SystemIntelligent/porteroInteligente/README.md

# Portero Inteligente
## Descripción
La idea de los creadores es tener un equipo encargado de comunicación con el celular para poder responder el llamado de la puerta y poder abrirla a distancia.

## Integrantes
* Leonardo Pastor
* Julian Morganella
* Ezequiel Valdez
* Ezequiel Silvero
