SystemIntelligent/porteroInteligente/plano electrico.pdf

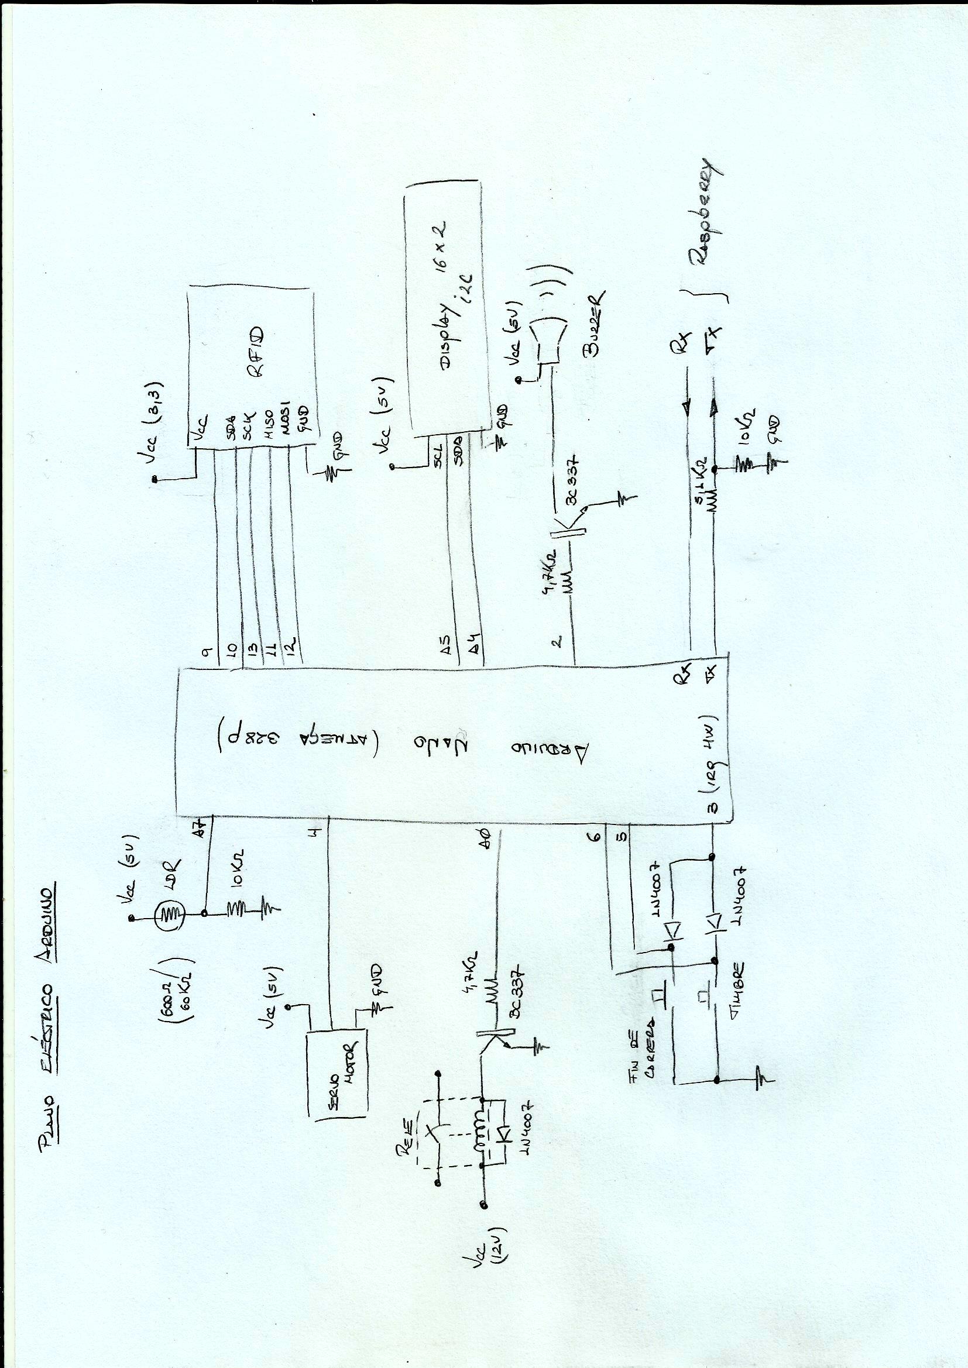
[picture p4: page 1]
