SystemIntelligent/porteroInteligente/(commit log)

2018-04-29 Create leame.txt
    Se creo la carpeta de Sistemas Embebido
2018-04-29 Create leame.txt
    Se creo el archivo leame.txt para la carpeta de Android
2018-04-29 Create leame.txt
    Se creo la carpeta Informe Final.
2018-04-29 Update README.md
    Se modificó archivo de readme
2018-05-27 * Primera versión: Prueba de Hardware involucrado en el proyecto.
    - Se probó comunicación (interfaz SPI) con módulo card reader (RFID RC522).
    - Se probó comunicación (interfaz I2C) con display de cristal Líquido 16x2.
    - Se probó buzzer.
    - Se probó biblioteca TimerOne, necesaria para utilizar el timer del ATmega328.
    - Se integraron los modulos antes descriptos, mostrando un mesaje en el display y
    emitiendo un pequeño beep cada vez que se aproxima una tarjeta al lector.
    - Actualmente no se lee ningún tipo de dato desde la tarjeta, sólo se verifica
    que la misma este en campo.
    [SmartDoorMan.ino]
2018-05-27 - Se agregó el handler que trata la interrupción de HW externa que se genera al presionar el pulsador.
2018-05-27 Se inició con la subida de archivos y ordenamiento de carpetas en eclipse.
2018-05-29 *Configuración de las propiedades del proyecto (lado raspberry, eclipse c++): - se deberá crea en el directorio raiz (ctr + t, para abrir una terminal y tipiar 'cd' luego 'cd ..' y por último una vez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
2018-05-29 - Se implemento el módulo sqlite, utilizado para interactuar con una base de datos. - Se incluyó una nueva carpeta en el proyecto 'common' donde se alojan los includes necesarios para todo el proyect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
2018-05-29 - Se configuro la estructura de carpetas, agregando las librerias faltantes.
2018-05-29 Update README.md
    Se elimina a compañera que dejó el equipo por problemas personales.
2018-05-30 * Se agregó el handler de evento serial --IMPORTANTE hay que tener encuanta que según la documentación este no es asincrónico si no que se ejecuta 1 vez por cada vuelta del loop() principal del progr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
2018-05-31 - Se le agregó a la función de evento Serial la lógica necesaria para reconocer la estructura de datos implementada en el protocolo que se va a utilizar para la comunicación entre arduino y raspberry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
2018-05-31 - Se realizaron nuevamente las configuraciones, para estandarizar con el resto de las personas del equipo
2018-05-31 - Se empezó a realizar el protocolo de armado de paquete, para la comunicación Raspberry con Arduino, del lado Raspberry.
2018-06-01 - Se agrega la funcion de checkSum para validar la veracidad de los datos enviados.
2018-06-01 - se modifico manera de armar vector de preparePack
2018-06-01 - Se corrigió problema en checkSum, y en lectura de serie.
2018-06-03 * Se agregaron todas las funciones requeridas para implementar el protocolo de comunicacón - char* calcChecksum(const char *data, int length) ---> Permite calcular el checksum de la carga útil del pa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
2018-06-03 * Se implementó la función respnsable de desarmar el paquete recibido. - char* disarmPackage(const char *package, int length);
2018-06-03 - Se definio una lista de comandos posibles (para la comunicación arduino raspberry). - Se mofidicó el tiempo de actualización del display. - Se modificó el tiempo de verificación de presencia de tar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
2018-06-03 Se corrigieron errores en el checkSum, se implemento un ejemplo de el envio con exito por el puerto serie
2018-06-03 - Se eliminaron todos los Serial.print en el proyecto y se defino una macro SERIAL_PRINT(x,y) para tal propósito pudiendose habilitar/deshabilitar el mismo.
2018-06-03 * Se implementó la función "int proccesPackage(String package, int length);" - Esta se encarga de procesar el paquete recibido. - Determinar el número de comando proveniente desde la raspberry. - y d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
2018-06-03 * Se agregó modulo en el loop principal encargado de la toma de desciciones según comando recibido.
2018-06-04 * Se eliminó la libreria timer One, ya que al incluir la libreria que permite controlar el servo entraba en conflicto con esta. * El seteo del timer ahora se realiza de forma manual accediendo direct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
2018-06-05 * Se creó la base de datos 'acceso.db' contiene una única tabla 'autorized-persons' con 2 columnas 'card_id' y 'name'
2018-06-05 - Se creo una clase intermedia al puerto serie. - Se desarrollo la recepción del mensaje.
2018-06-05 - Se agregó el envio y la recepcion a bajo nivel por el puerto serie.
2018-06-06 * Primera prueba del modulo SQLite, lo que se realizó fue una consulta a la DB para obtener el primer elemento de la tabla.
2018-06-06 * Se modificó la salida de DEBUG Serial antes se utilizaba el Serial por HW, ahora se utiliza el Serial por SW dejando disponible el Serial por HW para la comunicación con la raspberry. Además de agr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
2018-06-06 * Se agregó un método a la clase SQLite para poder realizar una consulta sobre la DB, que ejecuta la siguiente QUERY 'SELECT 'nombre de la columna' FROM 'nombre de la tabla' WHERE 'x = a'.
2018-06-07 - Se corrigió violación de segmento al recibir un mensaje.
2018-06-09 * Se agregó la función que se ocupa de leer la tarjeta RFID
2018-06-09 * commit de prueba - no se realizaron cambios -
2018-06-09 - Se agregó callBack a main de comunicación, para actraer logica. - Se limpio el proyecto.
2018-06-24 * Se modificó el loop principal, para darle mayor legibilidad al código todos los procesos antes realizados en el loop se implementaron en funciones: - void refreshServoPos(void); - bool checkPackage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
    * También se modificó la forma de pasar los mensajes a la función printMsg, antes se seteaba una variable con el número de mensaje
    a imprimir, ahora los mensajes se cargan a una cola (queue) estática, de este modo no se pierden los mensajes a mostrar debido a la
    superposición de eventos (dada a la alta velocidad de respuesta de la placa raspberry), se implementaron las siguientes funciones:
    - void push_Msg_inQue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
2018-06-24 * Se definió el comportamiento para el caso que la tarjeta a validar no aparezca en la base de datos.
2018-06-24 * Se agregó el módulo que trata el sensor LDR y activa un led (simulando ser una lámpara) el módulo implementa un ciclo de histeresis para tal fin.
2018-06-25 - Se creo el proyecto de android - Se realizó la pantalla principal. - Se creo una nueva Activity donde se setea la url donde estará el streaming de video. - Se agregó en el Manifest el acceso a inte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
2018-06-26 Se realiza la entrega del trabajo practico de HPC.
2018-06-26 - Se agregaron mail de 2 integrantes.
2018-06-26 - Se cambió la imagen de menu. - Se Cambió la imagen de la aplicacion. - Se agregó la posibilidad de hacer zoom en la app.
2018-06-28 - Se implementó el uso de sensores de proximidad. - Se creo label de prueba en la interfaz, para visualizar valores de sensores. - Se agregó en el manifest el sensor de proximidad. - Se Agregó shake 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
2018-07-05 - Se agregó un archivo de preferencias para poder guardar la direccion del video. - Se agregó servicio que intenta levantar el audio por rtp, pero no funciona por el momento. - Se agregó la implement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
2018-07-07 - Se hizo andar la transmición de audio de Android a Raspberry. - Se implementó el envio de Firebase. - Se agregó la implemtancion del cerrado del video cuando el celular se pone boca abajo. - Se sol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
2018-07-08 * Se modificó el tiempo de remanencia de los mensajes sobre el display.
2018-07-08 - Se arreglo el detenido del audio saliente del microfono. - Se arreglo el seteo de la ip en la aplicación. - Se arreglo problema que aveces no andaba la transmision de audio.
2018-07-08 * En el proyecto del lado arduino se agregó el envio de comando hacia la raspberry para que pueda reconocerce el evento 'timbre pulsado'
    * En el proyecto lado Raspberry se agregó código necesario para reconocer el
    comando que alerta que se preiono el timbre, y responder a tal evento.
2018-07-09 * Se implentó el módulo encargado de interactuar con los servicios de Firebases: - el intercambio de información con database firebases se realiza por medio de 2 script (python) - El módulo se ocupa 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
2018-07-09 * Se agregan 2 script implementados en python: - firebases.py --> Este se ocupa de obtener el estado de acciones requeridas, es decir si se requiere abrir puerta, cerrar puerta ó abrir mic. - firebas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
2018-07-09 - Se agregó la implementacion de llegada de mensajes desde la rasp - Se agregó el boton de abrir puerta. - Se agregó el envio de mensajes hacia la rasp, con microfono activo, abrir puerta, etc. - Se 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
2018-07-09 - Se corrigio el .gitignore
2018-07-10 * Se agregó sólo para cumplir con los requerimientos de la cátedra una salida analógica, Se enciende un led por medio de una señal pwm proporcional al valor obtenido del LDR.
2018-07-10 - Se solucionó problema que dejaba sin sonido al celular. - Se corrigío problema en la interfaz principal.
2018-07-10 - Se arreglaron problemas en la interzar horizontal.
